M-Welsch/base-hardware/circuit_boards/base_hmi/assembly/BaSe_HMI_V1_1.png

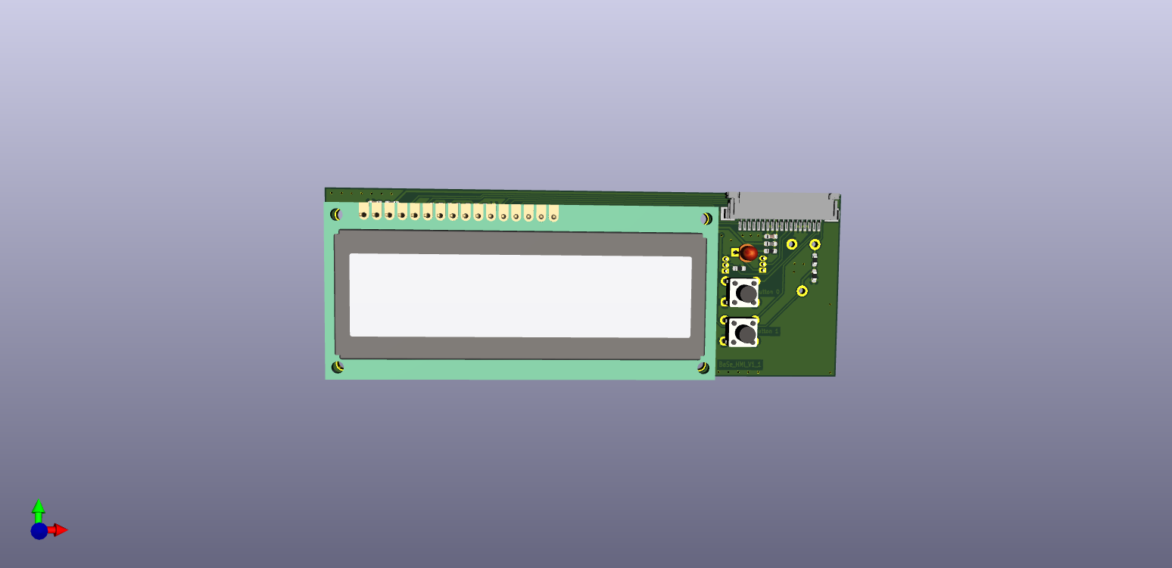
circuit_boards/base_hmi/assembly/BaSe_HMI_V1_1.png
