M-Welsch/base-hardware/bill_of_materials/BaSe_rev3b_Stueckliste_V1_0.pdf

Sheet1

## Stückliste BaSe HW rev3b

Position Bezeichnung | Menge Einzelpreis Gesamtpreis
100 | BananaPi Mk1 | 1 | 38,01 € | 38,01 €
200 | BaSe_PWR_V3_2 Leiterplatte | 0,2 | 11,30 € | 2,26 €
201 | BaSe_PWR_V3_2 Bauteile | 1 | 45,79 € | 45,79 €
202 | Schrittmotor Treibermodul | 0,2 | 7,99 € | 1,60 €
203 | Micro-USB Stecker | 0,05 | 9,39 € | 0,47 €
210 | BaSe_HMI_V1_1 Leiterplatte | 0,2 | 6,30 € | 1,26 €
211 | BaSe_HMI_V1_1 Bauteile | 1 | 4,77 € | 4,77 €
212 | Display Modul | 0,2 | 10,49 € | 2,10 €
220 | BaSe_SATA_Adapter_Carriage_V1_1 Leiterplatte | 0,2 | 3,00 € | 0,60 €
221 | BaSe_SATA_Adapter_Carriage_V1_1 Bauteile | 1 | 5,89 € | 5,89 €
230 | BaSe_SATA_Adapter_HDD_V1_1 Leiterplatte | 0,2 | 5,00 € | 1,00 €
231 | BaSe_SATA_Adapter_HDD_V1_1 Bauteile | 1 | 10,39 € | 10,39 €
300 | BaSe_Auflager_Platinen_rev3.stl
301 | BaSe_Bodenplatte_rev3.stl
302 | BaSe_BP_HDD_rev1.stl
303 | BaSe_HMI_Display_Abstandsrahmen_rev1.stl
304 | BaSe_rev1_Spannlager_Gegenstueck_2020_07_19.stl
305 | BaSe_Schlitten_rev3_2020_07_19.stl
400 | Schrittmotor: Nema 17 | 1 | 12,61 € | 12,61 €
401 | Gewindekupplungen | 0,2 | 7,99 € | 1,60 €
402 | Gewindestange (10cm) | 0,2 | 13,69 € | 2,74 €
403 | Linearführung + Gleitlager + Spannbacken | 1 | 7,89 € | 7,89 €
404 | Endschalter (KW4-3Z-3 Schnappsch gs) | 0,4 | 4,09 € | 1,64 €
| | | Summe | 140,61 €

Stand: 29.08.2020
