M-Welsch/base-hardware/3d_printing_parts/BaSe_BP_HDD_rev1.stl

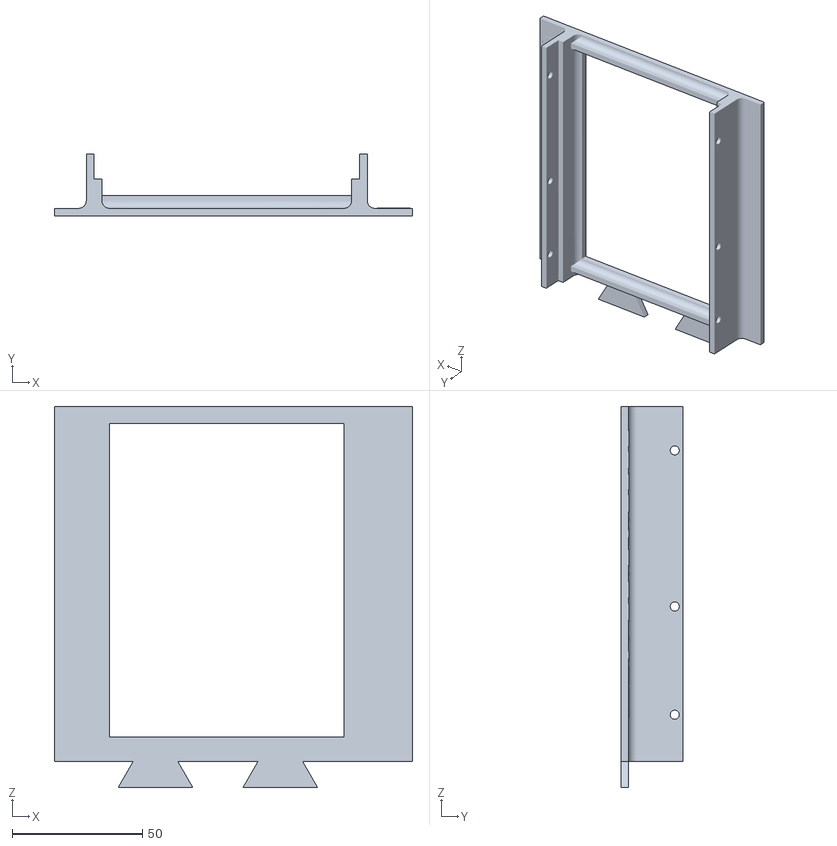
[picture p2: CAD file, 2023-03-08]
3d_printing_parts/BaSe_BP_HDD_rev1.stl
137.7 x 24.0 x 146.5
