M-Welsch/base-hardware/3d_printing_parts/BaSe_HMI_Display_Abstandsrahmen_rev1.stl

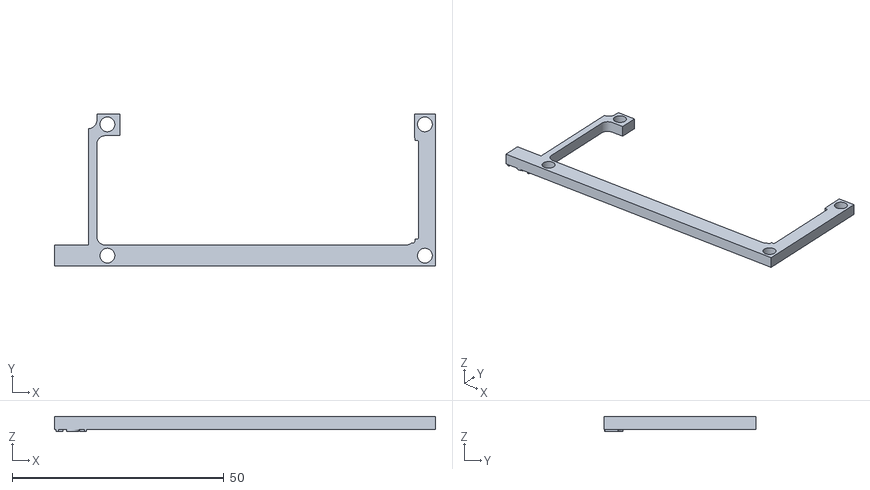
[picture p3: CAD file, 2023-03-08]
3d_printing_parts/BaSe_HMI_Display_Abstandsrahmen_rev1.stl
90.0 x 36.0 x 3.50
