M-Welsch/base-hardware/3d_printing_parts/BaSe_Auflager_Platinen_rev4.stl

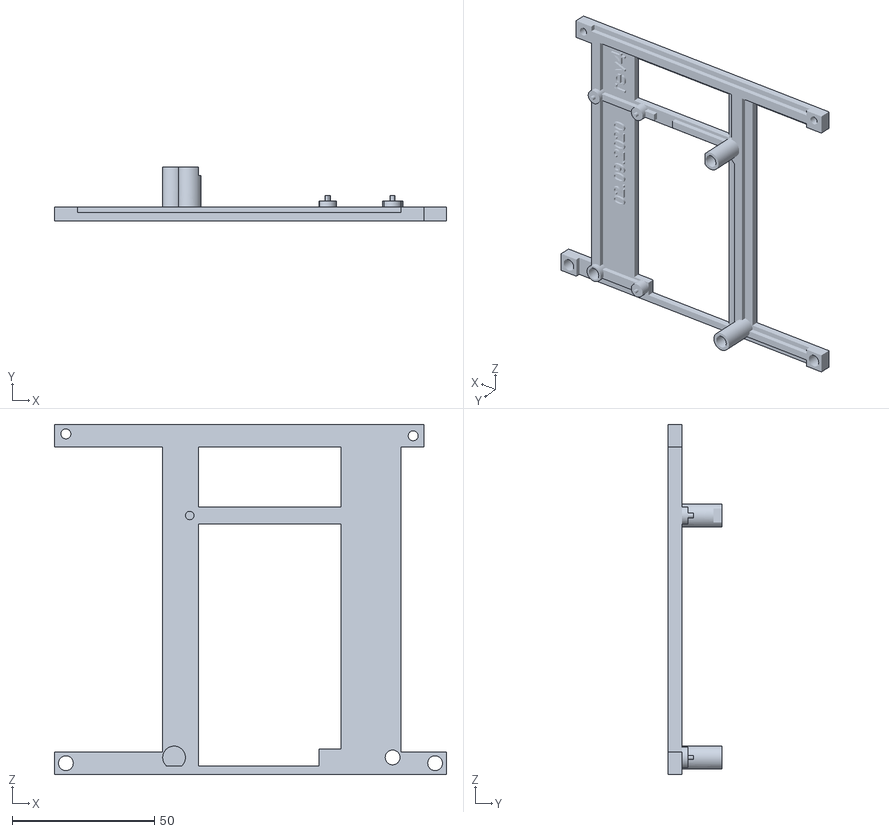
[picture p4: CAD file, 2023-03-08]
3d_printing_parts/BaSe_Auflager_Platinen_rev4.stl
137.7 x 19.0 x 123.0
