M-Welsch/base-hardware/3d_printing_parts/BaSe_Bodenplatte_rev3.stl

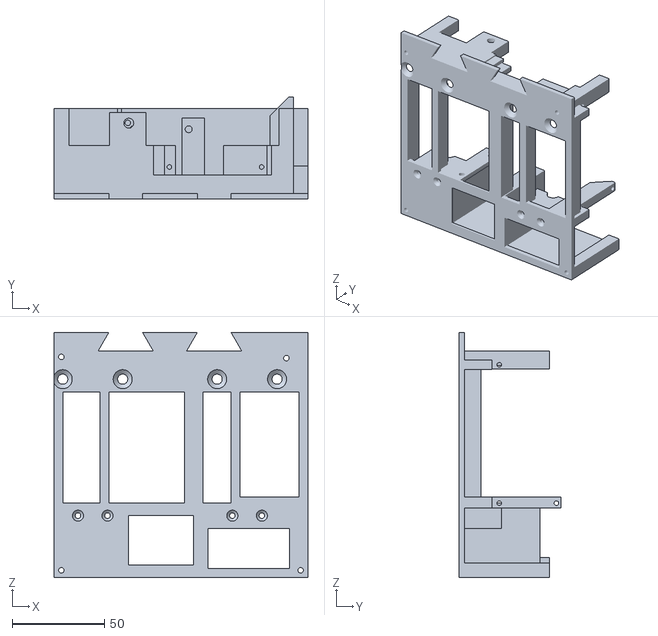
[picture p5: CAD file, 2023-03-08]
3d_printing_parts/BaSe_Bodenplatte_rev3.stl
137.7 x 55.3 x 133.0
