M-Welsch/base-hardware/3d_printing_parts/BaSe_rev1_Spannlager_Gegenstueck_2020_07_19.stl

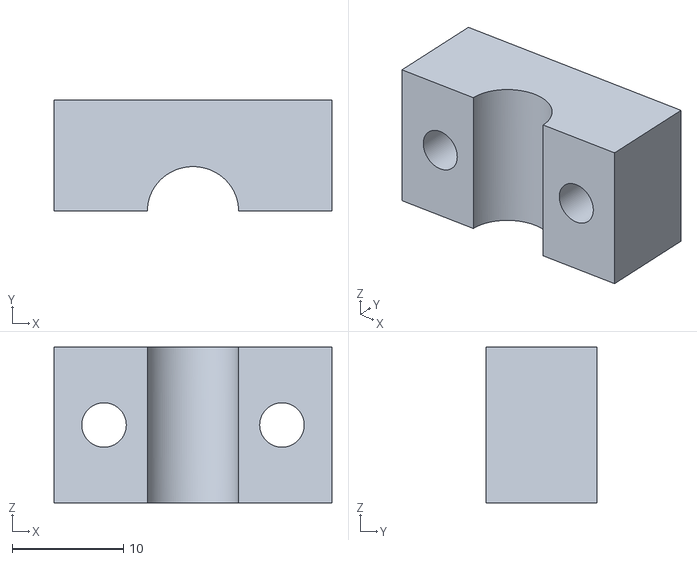
[picture p6: CAD file, 2023-03-08]
3d_printing_parts/BaSe_rev1_Spannlager_Gegenstueck_2020_07_19.stl
25.0 x 10.0 x 14.0
