M-Welsch/base-hardware/3d_printing_parts/BaSe_Schlitten_rev3_2020_07_19.stl

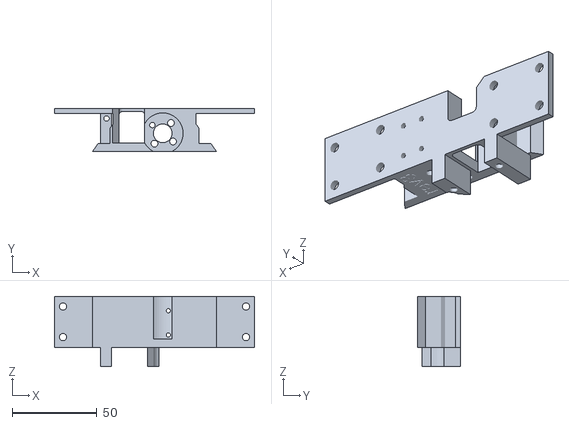
[picture p7: CAD file, 2023-03-08]
3d_printing_parts/BaSe_Schlitten_rev3_2020_07_19.stl
117.7 x 25.3 x 41.4
