M-Welsch/base-hardware/circuit_boards/base_pwr/BaSe_PWR_V4_0.kicad_pcb

## KiCad design circuit_boards/base_pwr/BaSe_PWR_V4_0.kicad_pcb (2024-01-03)

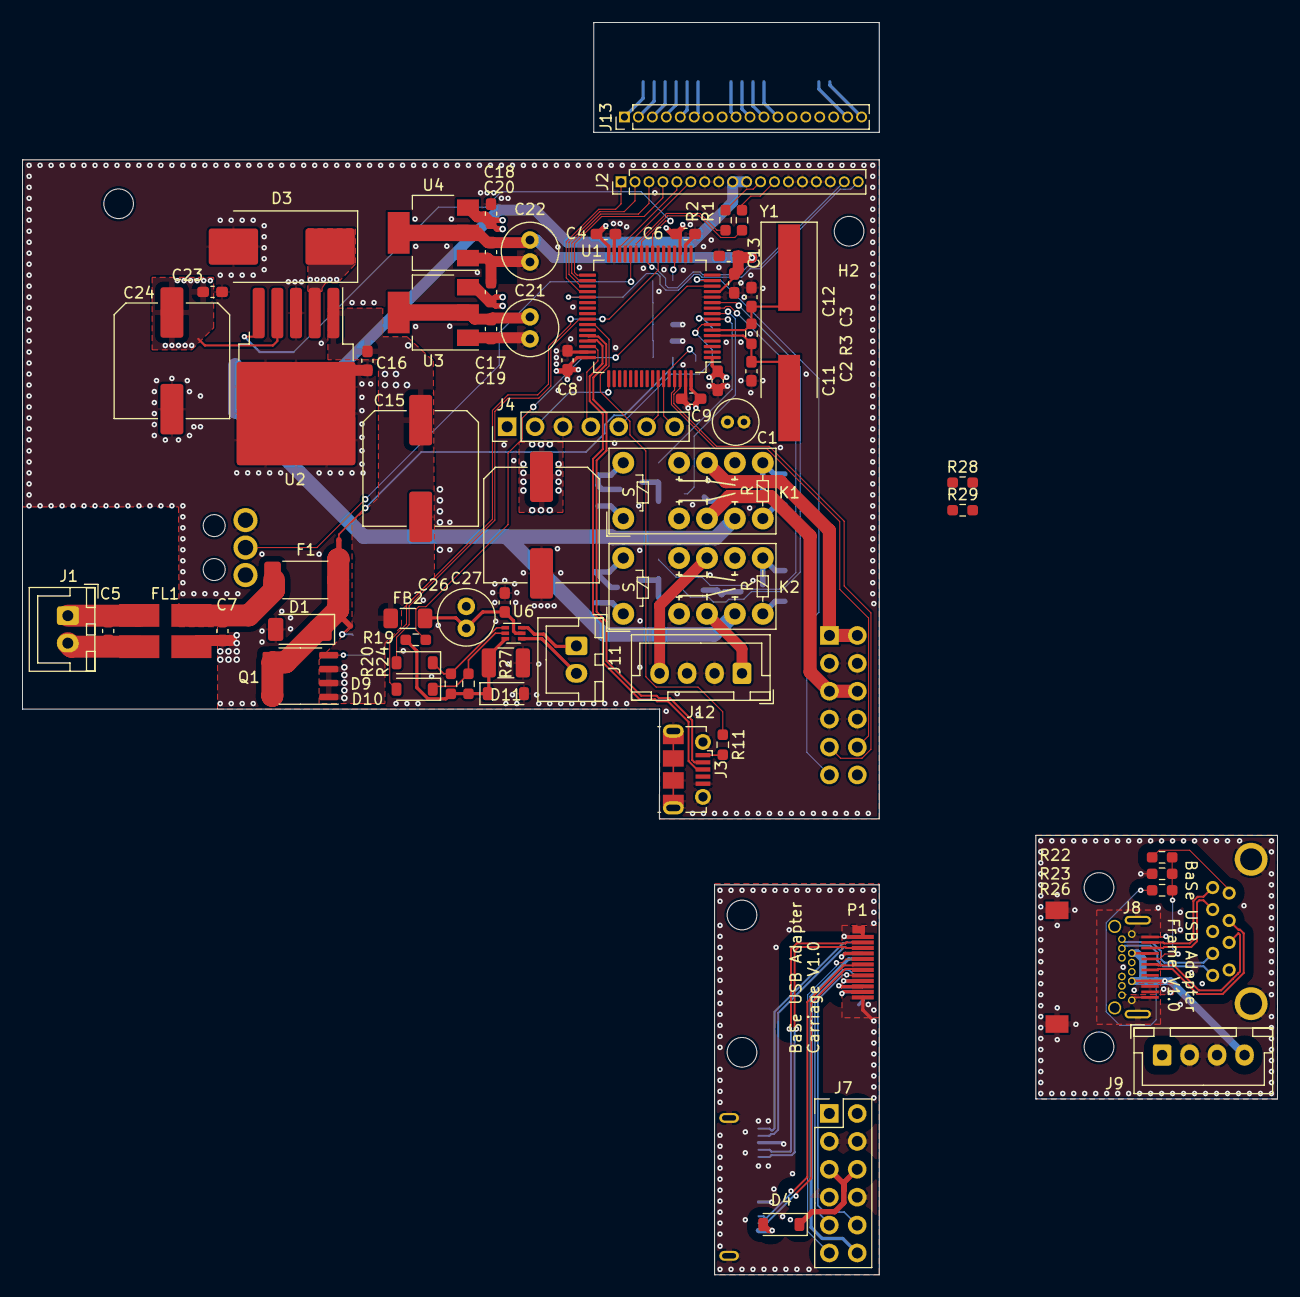
[picture p8: board BaSe_PWR_V4_0.kicad_pcb from above]

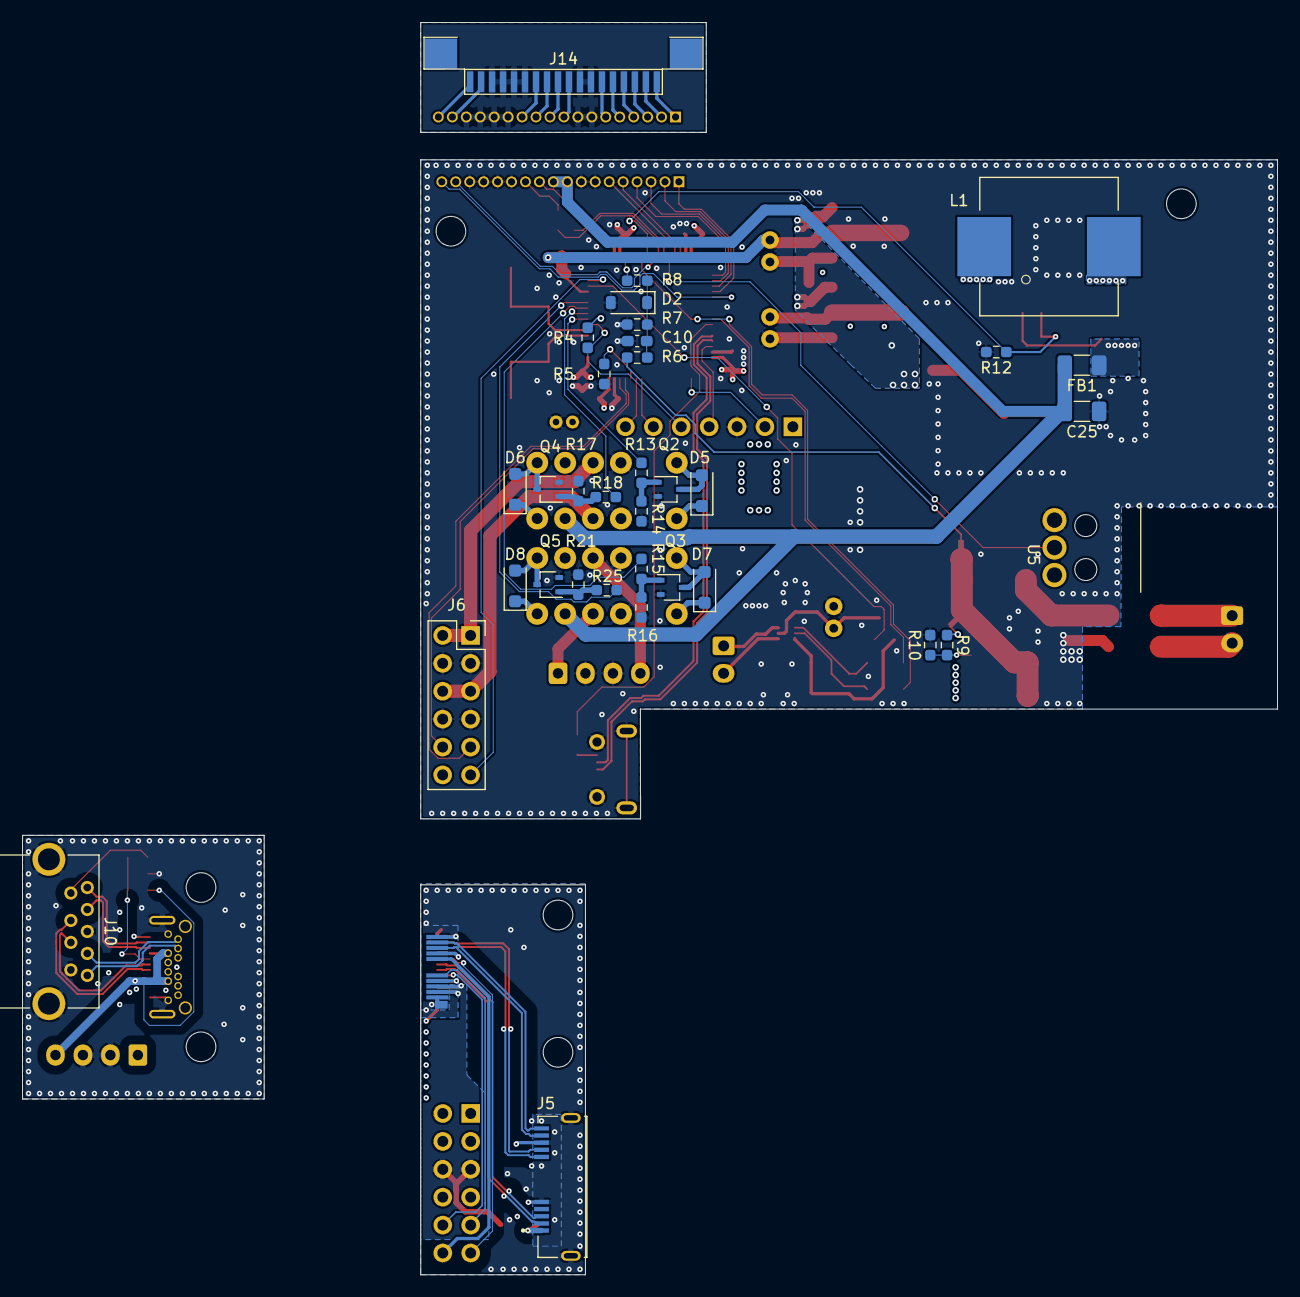
[picture p9: board BaSe_PWR_V4_0.kicad_pcb from below]

Board: 4 copper layers, 78.0 x 60.0 mm, 109 parts (34 on the bottom side), 106 nets.

Parts:
C1: 4.7µF; C_Radial_D4.0mm_H7.0mm_P1.50mm
C2, C3: 20pF; C_0603_1608Metric_Pad1.08x0.95mm_HandSolder
C4, C6, C8, C9, C10, C11, C16, C17, C18, C19, C20, C23, C27: 100nF; C_0603_1608Metric_Pad1.08x0.95mm_HandSolder
C5, C7: C_0603_1608Metric_Pad1.08x0.95mm_HandSolder
C12: 10nF; C_0603_1608Metric_Pad1.08x0.95mm_HandSolder
C13: 1µF; C_0603_1608Metric_Pad1.08x0.95mm_HandSolder
C14, C15, C24: 220µF; C_Elec_10x10.2
C21, C22, C26: 22µF; C_Radial_D5.0mm_H11.0mm_P2.00mm
C25: 10µF; C_1206_3216Metric_Pad1.33x1.80mm_HandSolder
D1: 824501121; D_SOD-128
D2, D9, D10: SD103CW-E3-08; D_SOD-123
D3: SK34-TP; D_SMC_Handsoldering
D4: SK64L-TPMSCT-ND; D_SOD-123
D5, D6, D7, D8: 1N4148WRHGCT-ND; D_SOD-123F
D11: 2.5V; D_SOD-123
F1: Fuse_2512_6332Metric_Pad1.52x3.35mm_HandSolder
FB1, FB2: FerriteBead; C_1206_3216Metric_Pad1.33x1.80mm_HandSolder
FL1: CMC_Laird_CM2021Y330R-10
H1, H2, H3, H4, H5, H6: MountingHole; MountingHole_2.7mm_M2.5_DIN965
J1: 12VDC In; JST_XH_B2B-XH-A_1x02_P2.50mm_Vertical
J2: HRS-1B-16-GA; PinHeader_1x18_P1.27mm_Vertical
J3: USB_B_Micro; USB_Micro-B_Molex-105017-0001
J4: Conn_01x07_Pin; PinHeader_1x07_P2.54mm_Vertical
J5: USB3_B_Micro; conn_usb3bmicro_GSB343K331HR
J6: Conn_02x06_Odd_Even; PinSocket_2x06_P2.54mm_Vertical
J7: Conn_02x06_Odd_Even; PinHeader_2x06_P2.54mm_Vertical
J8: USB_C_Receptacle; conn_usbc_socket_RAHPCUC31AU1TR
J9, J12: Conn_01x04_Socket; JST_XH_B4B-XH-A_1x04_P2.50mm_Vertical
J10: USB3_A; STEWARD_USB3_A_SS-52000-001
J11: MOTOR; JST_XH_B2B-XH-A_1x02_P2.50mm_Vertical
J13: HPH1-A-16-UA; PinHeader_1x18_P1.27mm_Vertical
J14: molex_fcc_05220
K1, K2: Kemet_EC2-12TNU
L1: 47µH; L_Wuerth_WE-PD-Typ-LS_Handsoldering
NT1, NT2: NetTie_2; NetTie-2_SMD_Pad0.5mm
P1: USB_C_Plug; Molex_USBC_Plug_1054440011
Q1: AOSP21321; SO-8_3.9x4.9mm_P1.27mm
Q2, Q3, Q4, Q5: BSS214NW; SOT-323_SC-70
R1, R2, R8, R10: 100; R_0603_1608Metric_Pad0.98x0.95mm_HandSolder
R3: R; R_0603_1608Metric_Pad0.98x0.95mm_HandSolder
R4, R5, R11, R20, R24, R28: 10k; R_0603_1608Metric_Pad0.98x0.95mm_HandSolder
R6, R9: 100k; R_0603_1608Metric_Pad0.98x0.95mm_HandSolder
R7: 24,9k; R_0603_1608Metric_Pad0.98x0.95mm_HandSolder
R12, R14, R16, R17, R21: 47k; R_0603_1608Metric_Pad0.98x0.95mm_HandSolder
R13, R15, R18, R19, R25: 1k; R_0603_1608Metric_Pad0.98x0.95mm_HandSolder
R22: 13,3k; R_0603_1608Metric_Pad0.98x0.95mm_HandSolder
R23: 3,16k; R_0603_1608Metric_Pad0.98x0.95mm_HandSolder
R26: 15,8k; R_0603_1608Metric_Pad0.98x0.95mm_HandSolder
R27: R; R_1210_3225Metric_Pad1.30x2.65mm_HandSolder
R29: 8,87k; R_0603_1608Metric_Pad0.98x0.95mm_HandSolder
U1: STM32F070RBTx; LQFP-64_10x10mm_P0.5mm
U2: LM2596S-5; TO-263-5_TabPin3
U3, U4: AMS1117-3.3; SOT-223-3_TabPin2
U5: TS0101F020V4
U6: DRV8220; SOT-563
Y1: 8MHz; Crystal_SMD_HC49-SD_HandSoldering

Connections:
+3.3VA: C12.1, C13.1, C20.1, C22.1, U1.13 (VDDA), U4.2 (VO)
+3V3_STBY: C1.1, C4.1, C6.1, C8.1, C9.1, C11.1, C19.1, C21.1, J4.1, J6.12, R4.2, R28.1, R29.2, U1.1 (VDD), U1.19 (VDD), U1.32 (VDD), U1.48 (VDD), U1.64 (VDD), U3.2 (VO)
+5V: C25.2, FB1.2, J2.9, J2.10, K1.5, K2.5
+5VA: J8.A10 (RX2-), J8.A11 (RX2+), J8.B2 (TX2+), J8.B3 (TX2-), J9.1, J10.1 (VBUS), R22.1
+12V: C14.1, C15.1, C16.2, C17.1, C18.1, D5.1 (K), D6.1 (K), D7.1 (K), D8.1 (K), FB2.1, K1.1, K1.6, K1.8, K2.1, K2.6, K2.8, Q1.1 (S), Q1.2 (S), Q1.3 (S), U2.1 (VIN), U3.3 (VI), U4.3 (VI)
+12VA: J8.A4 (VBUS), J8.A9 (VBUS), J8.B4 (VBUS), J8.B9 (VBUS), J9.4, R26.1
/12v_motor: C26.1, C27.1, FB2.2, U6.5 (VM)
/12vin_meas: R8.2, U1.20 (PA4)
/+5V_HDD: J6.5, J6.6, K1.4
/+5V_HDD_: D4.1 (K), J7.5, J7.6, P1.A10 (RX2-), P1.A11 (RX2+), P1.B2 (TX2+), P1.B3 (TX2-)
/+5V_sbu: J12.1, K2.4
/+5v_out: C23.2, C24.1, FB1.1, L1.2, U2.4 (FB)
/+12V_HDD: J6.1, J6.2, K1.9
/+12V_HDD_: J7.1, J7.2, P1.A4 (VBUS), P1.A9 (VBUS), P1.B4 (VBUS), P1.B9 (VBUS)
/+12V_sbu: J12.4, K2.9
/DC_IN+: C5.2, FL1.1, J1.1
/DC_IN-: C5.1, FL1.2, J1.2
/DC_prefuse: C7.1, F1.2, FL1.4
/DC_preprot: D1.1 (A1), F1.1, NT1.2, NT2.2, Q1.5 (D), Q1.6 (D), Q1.7 (D), Q1.8 (D)
/Dis_DB4: J2.4, U1.33 (PB12)
/Dis_DB5: J2.3, U1.34 (PB13)
/Dis_DB6: J2.2, U1.35 (PB14)
/Dis_DB7: J2.1, U1.36 (PB15)
/Dis_E: J2.5, U1.30 (PB11)
/Dis_PWM: J2.12, R1.2
/Dis_RS: J2.6, U1.29 (PB10)
/GND_HMI: J13.7, J13.8, J13.13, J13.14, J13.15, J13.16, J14.7, J14.8, J14.13, J14.14, J14.15, J14.16
/LED_HMI: J2.11, R2.2
/SW: D3.1 (K), L1.1, U2.2 (OUT)
/SW_HDD_Off: R18.1, U1.9 (PC1)
/SW_HDD_On: R13.1, U1.8 (PC0)
/Taster_0: J2.17, U1.25 (PC5)
/Taster_1: J2.18, U1.37 (PC6)
/USB_D+: J3.3 (D+), U1.45 (PA12)
/USB_D-: J3.2 (D-), U1.44 (PA11)
/aux_3v3: J7.12, P1.B8 (SBU2)
/aux_i2c_scl: J7.10, P1.A8 (SBU1)
/aux_i2c_sda: J7.9, P1.B5 (VCONN)
/boot0: R5.1, U1.60 (BOOT0)
/hmi_pwm0: R1.1, U1.26 (PB0)
/hmi_pwm1: R2.1, U1.27 (PB1)
/i2c1_scl: J6.10, U1.61 (PB8)
/i2c1_sda: J6.9, U1.62 (PB9)
/imotor: D11.1 (K), R19.2, R20.2, R24.2, R27.1, U6.3 (GND)
/imotor_prot: R19.1, U1.14 (PA0)
/in1: D9.1 (K), R20.1, U6.1 (IN1)
/in1_mcu: D9.2 (A), U1.41 (PA8)
/in2: D10.1 (K), R24.1, U6.2 (IN2)
/in2_mcu: D10.2 (A), U1.23 (PA7)
/l1_rx+: J8.B11 (RX1+), J10.6 (SSRX+)
/l1_rx-: J8.B10 (RX1-), J10.5 (SSRX-)
/l1_tx+: J8.A2 (TX1+), J10.9 (SSTX+)
/l1_tx-: J8.A3 (TX1-), J10.8 (SSTX-)
/lane1_d+: J8.A6 (D+), J10.3 (D+)
/lane1_d-: J8.A7 (D-), J10.2 (D-)
/motor1: J11.1, U6.6 (OUT1)
/motor2: J11.2, U6.4 (OUT2)
/stator_d+: J5.3 (D+), P1.A6 (D+)
/stator_d-: J5.2 (D-), P1.A7 (D-)
/stator_rx+: J5.10 (SSRX+), P1.B11 (RX1+)
/stator_rx-: J5.9 (SSRX-), P1.B10 (RX1-)
/stator_supply_sense: J6.11, R29.1, U1.15 (PA1)
/stator_supply_sense_: J7.11, P1.A5 (CC), R28.2
/stator_tx+: J5.7 (SSTX+), P1.A2 (TX1+)
/stator_tx-: J5.6 (SSTX-), P1.A3 (TX1-)
/supply_sense: J8.A5 (CC1), R22.2, R23.1, R26.2
/sw_sbu_off: R25.1, U1.11 (PC3)
/sw_sbu_on: R15.1, U1.10 (PC2)
/swclk: J4.2, U1.49 (PA14)
/swdio: J4.4, U1.46 (PA13)
/usart1_rx: J4.7, U1.59 (PB7)
/usart1_tx: J4.6, U1.58 (PB6)
/vbus_sense: R11.1, U1.42 (PA9)
/~LM2596S_ON: R12.1, U1.24 (PC4), U2.5 (~ON/OFF)
/~endswitch_undocked: U1.28 (PB2), U5.NO
/~rst: J4.5, R4.1, U1.7 (NRST)
GND: C1.2, C2.1, C3.1, C4.2, C6.2, C7.2, C8.2, C9.2, C10.2, C11.2, C12.2, C13.2, C14.2, C15.2, C16.1, C17.2, C18.2, C19.2, C20.2, C21.2, C22.2, C23.1, C24.2, C25.1, C26.2, C27.2, D1.2 (A2), D2.2 (A), D3.2 (A), D11.2 (A), FL1.3, J2.7, J2.8, J2.13, J2.14, J2.15, J2.16, J3.5 (GND), J3.6 (Shield), J4.3, J6.3, J6.4, J6.7, J6.8, J12.2, J12.3, K1.3, K1.10, K2.3, K2.10, Q2.2 (S), Q3.2 (S), Q4.2 (S), Q5.2 (S), R5.2, R7.1, R10.2, R12.2, R14.1, R16.1, R17.1, R21.1, R27.2, U1.12 (VSSA), U1.18 (VSS), U1.31 (VSS), U1.47 (VSS), U1.63 (VSS), U2.3 (GND), U3.1 (GND), U4.1 (GND), U5.C
GND1: J5.5 (GND), J5.8 (DRAIN), J5.11 (SHIELD), J7.3, J7.4, J7.7, J7.8, P1.A1 (GND), P1.A12 (GND), P1.B1 (GND), P1.B12 (GND), P1.S1 (SHIELD)
GND2: J8.A1 (GND), J8.A12 (GND), J8.B1 (GND), J8.B12 (GND), J8.S1 (SHIELD), J9.2, J9.3, J10.4 (GND), J10.7 (DRAIN), J10.10 (SHIELD), R23.2
unnamed: C10.1, D2.1 (K), R6.1, R7.2, R8.1
unnamed: D4.2 (A), J5.1 (VBUS)
unnamed: D5.2 (A), K1.12, Q2.3 (D)
unnamed: D6.2 (A), K1.7, Q4.3 (D)
unnamed: D7.2 (A), K2.12, Q3.3 (D)
unnamed: D8.2 (A), K2.7, Q5.3 (D)
unnamed: J3.1 (VBUS), R11.2
unnamed: J13.1, J14.1
unnamed: J13.2, J14.2
unnamed: J13.3, J14.3
unnamed: J13.4, J14.4
unnamed: J13.5, J14.5
unnamed: J13.6, J14.6
unnamed: J13.9, J13.10, J14.9, J14.10
unnamed: J13.11, J14.11
unnamed: J13.12, J14.12
unnamed: J13.17, J14.17
unnamed: J13.18, J14.18
unnamed: NT1.1, R6.2
unnamed: NT2.1, R9.1
unnamed: Q1.4 (G), R9.2, R10.1
unnamed: Q2.1 (G), R13.2, R14.2
unnamed: Q3.1 (G), R15.2, R16.2
unnamed: Q4.1 (G), R17.2, R18.2
unnamed: Q5.1 (G), R21.2, R25.2
unnamed: C2.2, R3.1, U1.5 (PF0), Y1.2
unnamed: C3.2, R3.2, U1.6 (PF1), Y1.1
