M-Welsch/base-hardware/circuit_boards/base_usb_adapter_carriage/BaSe_USB_Adapter_Carriage_V1_0.kicad_pcb

## KiCad design circuit_boards/base_usb_adapter_carriage/BaSe_USB_Adapter_Carriage_V1_0.kicad_pcb (2023-03-12)

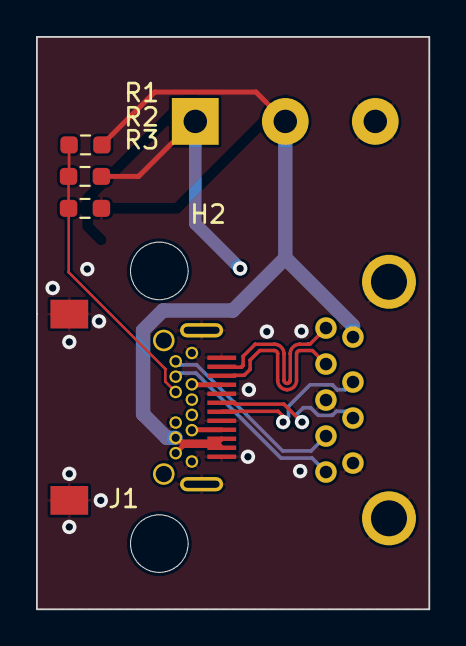
[picture p10: board BaSe_USB_Adapter_Carriage_V1_0.kicad_pcb from above]

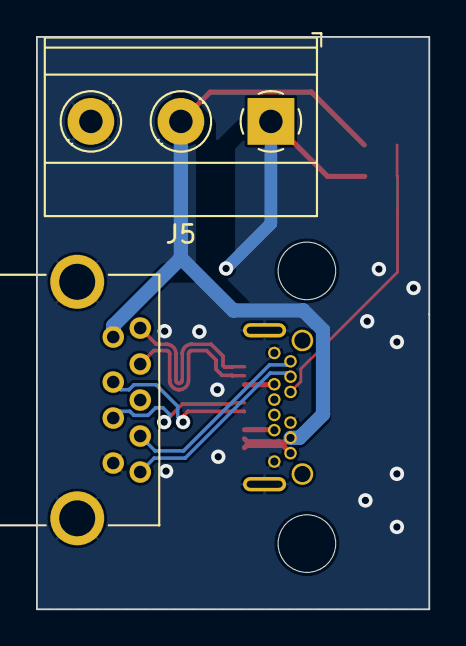
[picture p11: board BaSe_USB_Adapter_Carriage_V1_0.kicad_pcb from below]

Board: 4 copper layers, 21.8 x 31.8 mm, 8 parts (2 on the bottom side), 10 nets.

Parts:
H1, H2: MountingHole; MountingHole_3.2mm_M3_DIN965
J1: USB_C_Receptacle; conn_usbc_socket_RAHPCUC31AU1TR
J3: USB3_A; STEWARD_USB3_A_SS-52000-001
J5: Screw_Terminal_01x03; TerminalBlock_Phoenix_MKDS-1,5-3_1x03_P5.00mm_Horizontal
R1: 31k6; R_0603_1608Metric_Pad0.98x0.95mm_HandSolder
R2: 38k3; R_0603_1608Metric_Pad0.98x0.95mm_HandSolder
R3: 10k; R_0603_1608Metric_Pad0.98x0.95mm_HandSolder

Connections:
+5V: J1.A10 (RX2-), J1.A11 (RX2+), J1.B2 (TX2+), J1.B3 (TX2-), J3.1 (VBUS), J5.2, R1.1
+12V: J1.A4 (VBUS), J1.A9 (VBUS), J1.B4 (VBUS), J1.B9 (VBUS), J5.1, R2.1
/l1_rx+: J1.B11 (RX1+), J3.6 (SSRX+)
/l1_rx-: J1.B10 (RX1-), J3.5 (SSRX-)
/l1_tx+: J1.A2 (TX1+), J3.9 (SSTX+)
/l1_tx-: J1.A3 (TX1-), J3.8 (SSTX-)
/lane1_d+: J1.A6 (D+), J3.3 (D+)
/lane1_d-: J1.A7 (D-), J3.2 (D-)
/supply_sense: J1.B8 (SBU2), R1.2, R2.2, R3.1
GND2: J1.A1 (GND), J1.A5 (CC1), J1.A8 (SBU1), J1.A12 (GND), J1.B1 (GND), J1.B5 (CC2), J1.B12 (GND), J1.S1 (SHIELD), J3.4 (GND), J3.7 (DRAIN), J3.10 (SHIELD), J5.3, R3.2
