M-Welsch/base-hardware/circuit_boards/base_dc_motor_test/BaSe_DC_Motor_Test_V1_0.kicad_pcb

## KiCad design circuit_boards/base_dc_motor_test/BaSe_DC_Motor_Test_V1_0.kicad_pcb (2023-03-08)

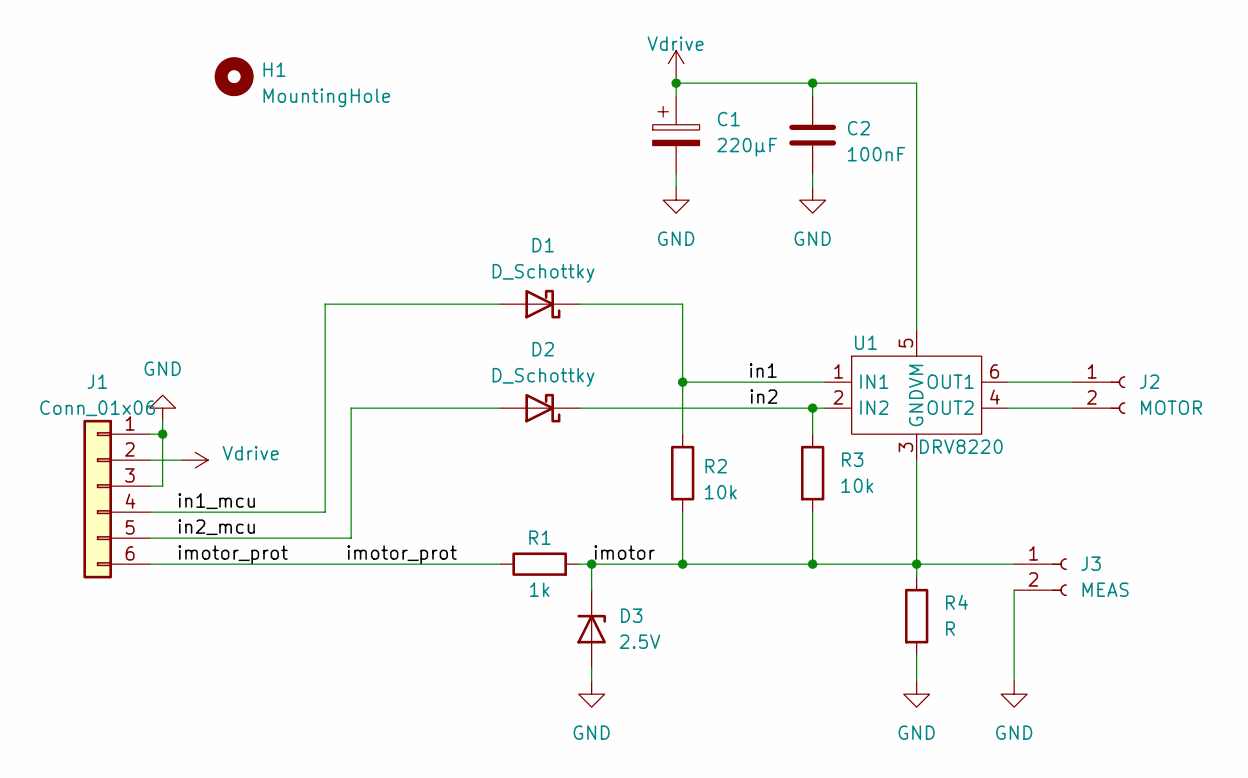
[picture p12: schematic BaSe_DC_Motor_Test_V1_0.kicad_sch]

Parts:
C1: 220µF; C_Elec_6.3x7.7
C2: 100nF; C_0603_1608Metric_Pad1.08x0.95mm_HandSolder
D1, D2: D_Schottky; D_SOD-123; MPN SD103CW-E3-08
D3: 2.5V; D_SOD-123
H1: MountingHole; MountingHole_3.2mm_M3
J1: Conn_01x06; PinHeader_1x06_P2.54mm_Vertical
J2: MOTOR; PinHeader_1x02_P2.54mm_Vertical
J3: MEAS; PinHeader_1x02_P2.54mm_Vertical
R1: 1k; R_0603_1608Metric_Pad0.98x0.95mm_HandSolder
R2, R3: 10k; R_0603_1608Metric_Pad0.98x0.95mm_HandSolder
R4: R; R_1210_3225Metric_Pad1.30x2.65mm_HandSolder
U1: DRV8220; SOT-563

Connections:
/imotor: D3.1 (K), J3.1, R1.2, R2.2, R3.2, R4.1, U1.3 (GND)
/imotor_prot: J1.6, R1.1
/in1: D1.1 (K), R2.1, U1.1 (IN1)
/in1_mcu: D1.2 (A), J1.4
/in2: D2.1 (K), R3.1, U1.2 (IN2)
/in2_mcu: D2.2 (A), J1.5
GND: C1.2, C2.2, D3.2 (A), J1.1, J1.3, J3.2, R4.2
unnamed: J2.1, U1.6 (OUT1)
unnamed: J2.2, U1.4 (OUT2)
Vdrive: C1.1, C2.1, J1.2, U1.5 (VM)

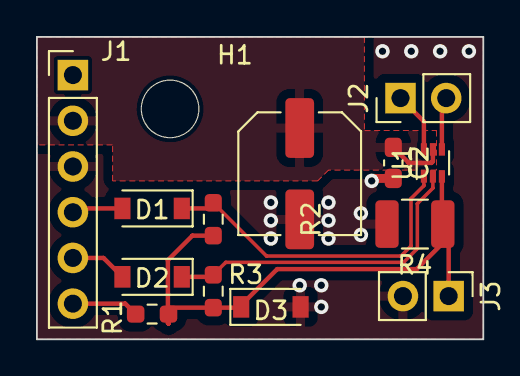
[picture p13: board BaSe_DC_Motor_Test_V1_0.kicad_pcb from above]

Board: 2 copper layers, 24.8 x 16.8 mm, 14 parts (0 on the bottom side), 10 nets.
