M-Welsch/base-hardware/circuit_boards/base_hmi/BaSe_HMI_V1_1.kicad_pcb

## KiCad design circuit_boards/base_hmi/BaSe_HMI_V1_1.kicad_pcb (2023-03-08)

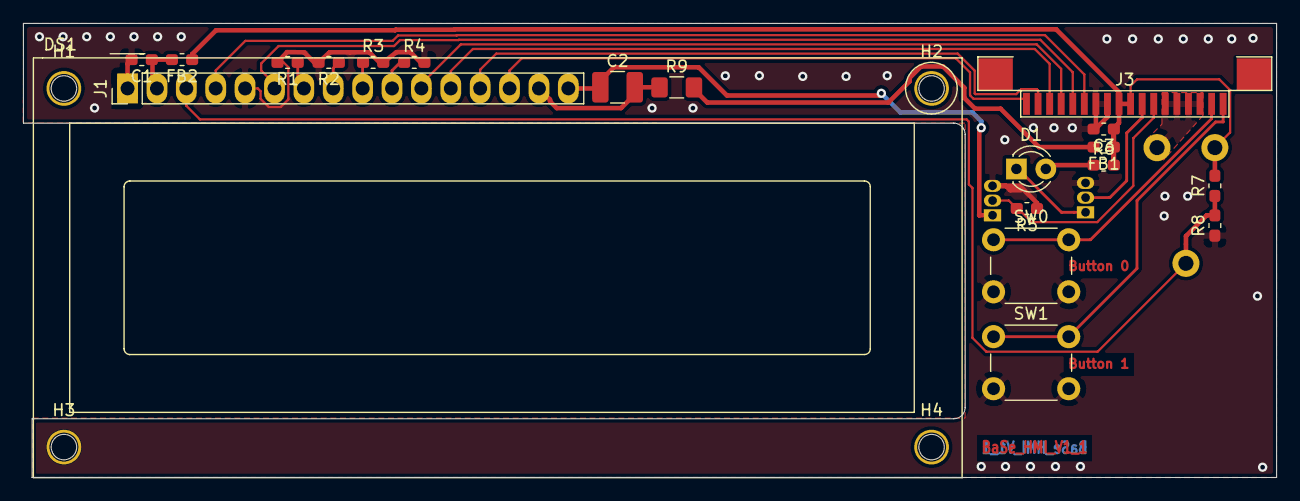
[picture p14: board BaSe_HMI_V1_1.kicad_pcb from above]

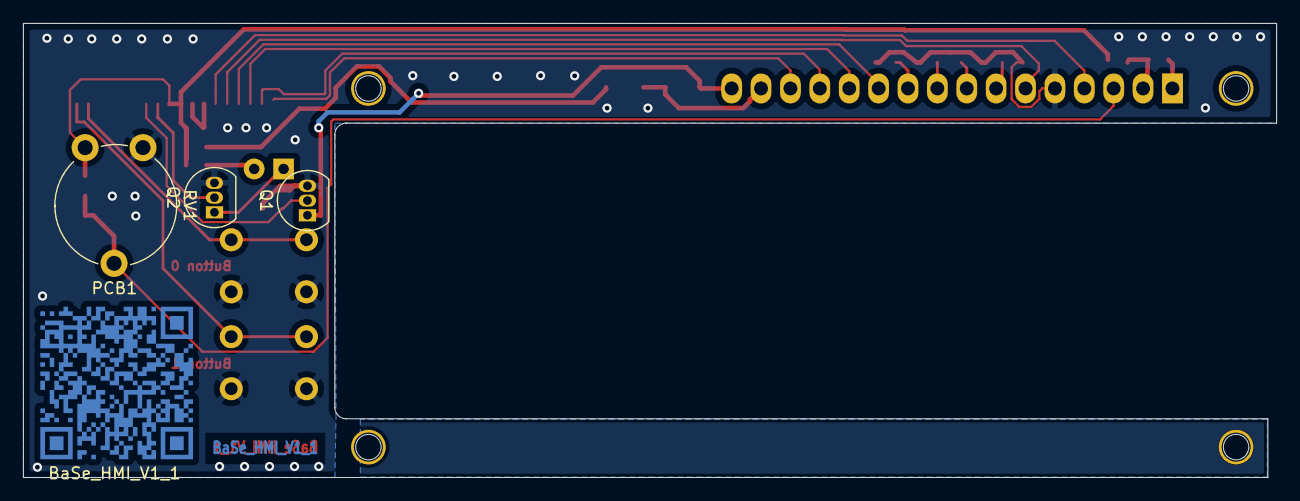
[picture p15: board BaSe_HMI_V1_1.kicad_pcb from below]

Board: 2 copper layers, 108.3 x 39.2 mm, 28 parts (4 on the bottom side), 23 nets.

Parts:
C1, C3: 100nF; C_0603_1608Metric_Pad1.05x0.95mm_HandSolder
C2: 100µF; C_1210_3225Metric_Pad1.42x2.65mm_HandSolder
D1: LED; LED_D3.0mm_9.5mm_Standoff
DS1: WC1602A; WC1602A_3.5mm_over_PCB
FB1, FB2: 742792602; L_0603_1608Metric_Pad1.05x0.95mm_HandSolder
H1, H2, H3, H4: MountingHole; MountingHole_2.2mm_M2
J1: Conn_01x16; PinHeader_1x16_P2.54mm_Vertical
J3: 0522071860; Conn_FFC_Molex_52207-1860
PCB1: BaSe_HMI_V1_1
Q1, Q2: BS170; TO-92_Inline
R1, R2, R3, R4: NO; R_0603_1608Metric_Pad1.05x0.95mm_HandSolder
R5: 10k; R_0603_1608Metric_Pad1.05x0.95mm_HandSolder
R6: 56R; R_0603_1608Metric_Pad1.05x0.95mm_HandSolder
R7: 43k; R_0603_1608Metric_Pad1.05x0.95mm_HandSolder
R8: 2k2; R_0603_1608Metric_Pad1.05x0.95mm_HandSolder
R9: 4,3R; R_1206_3216Metric_Pad1.42x1.75mm_HandSolder
RV1: R_POT; Potentiometer_Piher_PT-10-V10_Vertical
SW0, SW1: SW_Push; SW_PUSH_6mm_H7.3mm

Connections:
+5V: C3.1, FB1.1, FB2.1, J3.9, J3.10, R6.2, R7.2, RV1.1
/Dis_DB4: DS1.11, J1.11, J3.15
/Dis_DB5: DS1.12, J1.12, J3.16
/Dis_DB6: DS1.13, J1.13, J3.17
/Dis_DB7: DS1.14, J1.14, J3.18
/Dis_E: DS1.6, J3.14
/Dis_PWM: J3.7, Q1.2, R5.2
/Dis_RS: DS1.4, J3.13
/Dis_Vdd: C1.1, DS1.2, FB2.2
/LED+: C2.2, DS1.15, J1.15, R9.1
/LED-: C2.1, DS1.16, J1.16, Q1.1
/LED_HMI: J3.8, Q2.2
/Taster_0: J3.2, SW0.1
/Taster_1: J3.1, SW1.1
GND: C1.2, C3.2, DS1.1, DS1.5, J1.1, J1.5, J3.3, J3.4, J3.5, J3.6, J3.11, J3.12, Q1.3, Q2.3, R1.2, R2.2, R3.2, R4.2, R5.1, R8.1, RV1.3, SW0.2, SW1.2
unnamed: D1.1, Q2.1
unnamed: D1.2, R6.1
unnamed: DS1.3, R7.1, R8.2, RV1.2
unnamed: DS1.7, R1.1
unnamed: DS1.8, R2.1
unnamed: DS1.9, R3.1
unnamed: DS1.10, R4.1
unnamed: FB1.2, R9.2
