M-Welsch/base-hardware/circuit_boards/base_sata_adapter_hdd/BaSe_SATA_Adapter_HDD_V1_0.kicad_pcb

## KiCad design circuit_boards/base_sata_adapter_hdd/BaSe_SATA_Adapter_HDD_V1_0.kicad_pcb (2023-03-08)

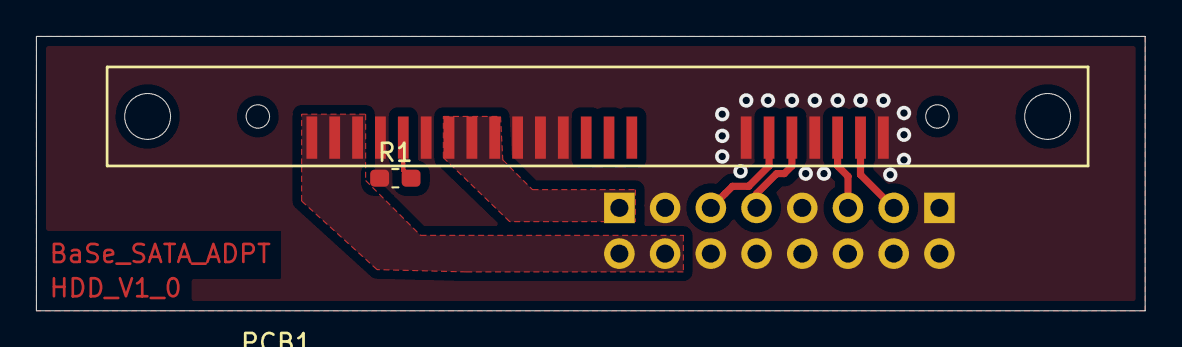
[picture p16: board BaSe_SATA_Adapter_HDD_V1_0.kicad_pcb from above]

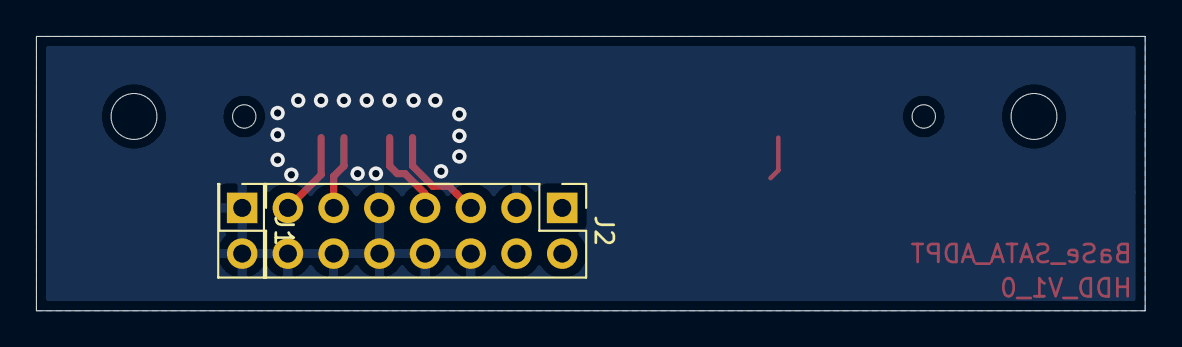
[picture p17: board BaSe_SATA_Adapter_HDD_V1_0.kicad_pcb from below]

Board: 2 copper layers, 61.6 x 15.2 mm, 5 parts (2 on the bottom side), 8 nets.

Parts:
J1: 821-22-002-10-002101; Conn_Spring_MaxMill_821-22-002-10-002101
J2: 823-22-014-10-001101; Conn_Spring_MaxMill_823-22-014-10-001101
PCB1: BaSe_SATA_Adapter_V1_0; BaSe_SATA_Adapter_HDD_V1_0
R1: No; R_0603_1608Metric_Pad1.05x0.95mm_HandSolder
X1: SATA_CONNECTOR_FEM; Conn_SATA_FEM_3M_5622-2222

Connections:
+5V: J2.1, X1.P7, X1.P8, X1.P9
+12V: J2.2, J2.4, X1.P13, X1.P14, X1.P15
/HDD_Rx+: J2.5, X1.S6
/HDD_Rx-: J2.7, X1.S5
/HDD_Tx+: J2.13, X1.S2
/HDD_Tx-: J2.11, X1.S3
/SPINUP_HDD: R1.2, X1.P11
GND: J1.1, J1.2, J2.3, J2.6, J2.8, J2.9, J2.10, J2.12, J2.14, R1.1, X1.P4, X1.P5, X1.P6, X1.P10, X1.P12, X1.S1, X1.S4, X1.S7
