M-Welsch/base-hardware/circuit_boards/base_dc_motor_test/base.kibot.yaml

# This is a working example.
# For a more complete reference use `--example`
kibot:
  version: 1

global:
  filters:
  - number: 1007
  - number: 1015
  - number: 58

filters:
- name: only_jlc_parts
  comment: Only parts with JLC (LCSC) code
  type: generic
  include_only:
  - column: LCSC#
    regex: ^C\d+

variants:
- name: place_holder
  comment: Just a place holder for pre_transform filters
  type: kicost
  pre_transform:
  - _kicost_rename
  - _rot_footprint

preflight:
  # [dict|list(dict)] Defines KiCad 6 variables.
  # They are expanded using ${VARIABLE}, and stored in the project file.
  # This preflight replaces `pcb_replace` and `sch_replace` when using KiCad 6.
  # The KiCad project file is modified.
  set_text_variables:
    - name: 'git_hash'
      command: 'git log -1 --format="%h" $KIBOT_PCB_NAME'
      before: 'Git hash: <'
      after: '>'

outputs:
- name: generic_bom_html
  comment: Generic Bill of Materials in HTML format
  type: bom
  dir: BoM/Generic
  options:
    format: HTML
    count_smd_tht: true
    columns:
    - References
    - Footprint
    - Quantity Per PCB
    - Value
    - MPN
    - Alternate
    - Description
- name: generic_bom_csv
  comment: Generic Bill of Materials in CSV format
  type: bom
  dir: BoM/Generic
  options:
    format: CSV
    count_smd_tht: true
    columns:
    - References
    - Footprint
    - Quantity Per PCB
    - Value
    - MPN
    - Alternate
    - Description
- name: generic_bom_xlsx
  comment: Generic Bill of Materials in XLSX format
  type: bom
  dir: BoM/Generic
  options:
    format: XLSX
    count_smd_tht: true
    columns:
    - References
    - Footprint
    - Quantity Per PCB
    - Value
    - MPN
    - Alternate
    - Description
- name: positional_bom_html
  comment: Positional Bill of Materials in HTML format
  type: bom
  dir: BoM/Positional
  options:
    format: HTML
    columns: &id001
    - Row
    - Description
    - Part
    - Part Lib
    - References
    - Value
    - Footprint
    - Footprint Lib
    - Quantity Per PCB
    - Build Quantity
    - Status
    - Datasheet
    - Sheetpath
    - Source BoM
    - Footprint X
    - Footprint Y
    - Footprint Rot
    - Footprint Side
    - Footprint Type
    - Footprint Populate
    - Footprint X-Size
    - Footprint Y-Size
    count_smd_tht: true
    html:
      style: modern-red
- name: positional_bom_xlsx
  comment: Positional Bill of Materials in XLSX format
  type: bom
  dir: BoM/Positional
  options:
    format: XLSX
    columns: *id001
    count_smd_tht: true
    xlsx:
      style: modern-red
- name: basic_excellon
  comment: Drill files in EXCELLON format
  type: excellon
  dir: Gerbers_and_Drill
  options:
    map: pdf
- name: basic_gencad
  comment: PCB in GenCAD format
  type: gencad
  dir: Export
- name: basic_gerb_drill
  comment: Drill files in GERB_DRILL format
  type: gerb_drill
  dir: Gerbers_and_Drill
  options:
    map: gerber
- name: gerber_modern
  comment: Gerbers in modern format, recommended by the standard
  type: gerber
  dir: Gerbers_and_Drill
  layers:
  - layer: F.Cu
    suffix: F_Cu
    description: Front copper
  - layer: B.Cu
    suffix: B_Cu
    description: Bottom copper
  - layer: F.Paste
    suffix: F_Paste
    description: Front solder paste
  - layer: B.Silkscreen
    suffix: B_Silkscreen
    description: Bottom silkscreen (artwork)
  - layer: F.Silkscreen
    suffix: F_Silkscreen
    description: Front silkscreen (artwork)
  - layer: B.Mask
    suffix: B_Mask
    description: Bottom soldermask (negative)
  - layer: F.Mask
    suffix: F_Mask
    description: Front soldermask (negative)
  - layer: User.Drawings
    suffix: User_Drawings
    description: User drawings
  - layer: User.Comments
    suffix: User_Comments
    description: User comments
  - layer: Edge.Cuts
    suffix: Edge_Cuts
    description: Board shape
  - layer: B.Courtyard
    suffix: B_Courtyard
    description: Bottom courtyard area
  - layer: F.Courtyard
    suffix: F_Courtyard
    description: Front courtyard area
  - layer: B.Fab
    suffix: B_Fab
    description: Bottom documentation
  - layer: F.Fab
    suffix: F_Fab
    description: Front documentation
- name: basic_info
  comment: Information about the run
  type: info
  dir: .
- name: classic_netlist
  comment: Schematic netlist in KiCad format
  type: netlist
  dir: Export
- name: ipc_netlist
  comment: IPC-D-356 netlist for testing
  type: netlist
  dir: Export
  options:
    format: ipc
- name: basic_pcb_print_pdf
  comment: PCB
  type: pcb_print
  dir: PCB
  options:
    format: PDF
    pages:
    - layers:
      - layer: F.Cu
      - layer: F.Mask
        color: '#14332440'
      - layer: F.Paste
      - layer: F.Silkscreen
      - layer: Edge.Cuts
      - layer: User.Drawings
      - layer: User.Comments
      sheet: Front copper
    - layers:
      - layer: B.Cu
      - layer: B.Mask
        color: '#14332440'
      - layer: B.Silkscreen
      - layer: Edge.Cuts
      - layer: User.Drawings
      - layer: User.Comments
      mirror: true
      sheet: Bottom copper
    - layers:
      - layer: B.Courtyard
      - layer: Edge.Cuts
      - layer: User.Drawings
      - layer: User.Comments
      mirror: true
      sheet: Bottom courtyard area
    - layers:
      - layer: F.Courtyard
      - layer: Edge.Cuts
      - layer: User.Drawings
      - layer: User.Comments
      sheet: Front courtyard area
    - layers:
      - layer: B.Fab
      - layer: Edge.Cuts
      - layer: User.Drawings
      - layer: User.Comments
      mirror: true
      sheet: Bottom documentation
    - layers:
      - layer: F.Fab
      - layer: Edge.Cuts
      - layer: User.Drawings
      - layer: User.Comments
      sheet: Front documentation
    keep_temporal_files: true
- name: basic_pdf
  comment: Individual layers in PDF format
  type: pdf
  dir: Individual_Layers
  layers:
  - layer: F.Cu
    suffix: F_Cu
    description: Front copper
  - layer: B.Cu
    suffix: B_Cu
    description: Bottom copper
  - layer: F.Paste
    suffix: F_Paste
    description: Front solder paste
  - layer: B.Silkscreen
    suffix: B_Silkscreen
    description: Bottom silkscreen (artwork)
  - layer: F.Silkscreen
    suffix: F_Silkscreen
    description: Front silkscreen (artwork)
  - layer: B.Mask
    suffix: B_Mask
    description: Bottom soldermask (negative)
  - layer: F.Mask
    suffix: F_Mask
    description: Front soldermask (negative)
  - layer: User.Drawings
    suffix: User_Drawings
    description: User drawings
  - layer: User.Comments
    suffix: User_Comments
    description: User comments
  - layer: Edge.Cuts
    suffix: Edge_Cuts
    description: Board shape
  - layer: B.Courtyard
    suffix: B_Courtyard
    description: Bottom courtyard area
  - layer: F.Courtyard
    suffix: F_Courtyard
    description: Front courtyard area
  - layer: B.Fab
    suffix: B_Fab
    description: Bottom documentation
  - layer: F.Fab
    suffix: F_Fab
    description: Front documentation
- name: basic_pdf_sch_print
  comment: Schematic in PDF format
  type: pdf_sch_print
  dir: Schematic
- name: basic_position_ASCII
  comment: Components position for Pick & Place
  type: position
  dir: Position
  options:
    format: ASCII
    only_smd: false
- name: basic_position_CSV
  comment: Components position for Pick & Place
  type: position
  dir: Position
  options:
    format: CSV
    only_smd: false
- name: basic_render_3d_top
  comment: 3D view from top
  type: render_3d
  dir: 3D
  options:
    ray_tracing: true
    orthographic: true
- name: basic_render_3d_30deg
  comment: 3D view from 30 degrees
  type: render_3d
  dir: 3D
  output_id: 30deg
  options:
    ray_tracing: true
    rotate_x: 3
    rotate_z: -2
- name: basic_render_3d_bottom
  comment: 3D view from bottom
  type: render_3d
  dir: 3D
  options:
    ray_tracing: true
    orthographic: true
    view: bottom
- name: report_simple
  comment: Simple design report
  type: report
  output_id: _simple
  options:
    template: simple_ASCII
- name: report_full
  comment: Full design report
  type: report
  options:
    template: full_SVG
- name: basic_step
  comment: 3D model in STEP format
  type: step
  dir: 3D
