M-Welsch/base-hardware/(commit log)

2023-03-07 second version, never built up. First version has no kicad files, just hand-sketches
    [Additional_Outputs.kicad_sch, BackupServer.kicad_sch, Motor_Driver.kicad_sch, Power_Distribution.kicad_sch]
2023-03-07 v2.0, made of the blue breadboard
    [Additional_Outputs.kicad_sch, BackupServer.kicad_sch, Motor_Driver.kicad_sch, Power_Distribution.kicad_sch]
2023-03-07 v3 with raspberry pi 4
    [BaSe_PWR_V3_1.kicad_pcb, BaSe_PWR_V3_1.kicad_sch, BackupServer.kicad_sch]
2023-03-08 new base pwr version
    [BaSe_PWR_V3_2.kicad_pcb, BaSe_PWR_V3_2.kicad_sch]
2023-03-08 first hmi board version
    [BaSe_HMI_V1_0.kicad_pcb, BaSe_HMI_V1_0.kicad_sch, BaSe_PWR_V3_1.kicad_pcb, BaSe_PWR_V3_1.kicad_sch]
2023-03-08 first version of sata adapter boards
    [BaSe_SATA_Adapter_Carriage_V1_0.kicad_pcb, BaSe_SATA_Adapter_Carriage_V1_0.kicad_sch, BaSe_SATA_Adapter_HDD_V1_0.kicad_pcb, BaSe_SATA_Adapter_HDD_V1_0.sch]
2023-03-08 production ready versions of sata adapter boards
    [BaSe_SATA_Adapter_Carriage_V1_0.kicad_pcb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]
2023-03-08 production ready version of base pwr
    [BaSe_PWR_V3_2-B_Mask.gbr, BaSe_PWR_V3_2-B_Paste.gbr, BaSe_PWR_V3_2-Edge_Cuts.gbr, BaSe_PWR_V3_2-F_Mask.gbr, BaSe_PWR_V3_2-F_Paste.gbr, BaSe_PWR_V3_2-L1_Sig_GND.gbr, BaSe_PWR_V3_2-L2_PWR_Split.gbr, BaSe_PWR_V3_2-L3_GND.gbr]
2023-03-08 production ready version of base hmi
    [BaSe_HMI_V1_0.kicad_pcb, BaSe_HMI_V1_0.kicad_sch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]
2023-03-08 add 3d printing parts (stl files)
    [BaSe_Auflager_Platinen_rev4.stl, BaSe_BP_HDD_rev1.stl, BaSe_Bodenplatte_rev3.stl, BaSe_HMI_Display_Abstandsrahmen_rev1.stl, BaSe_Schlitten_rev3_2020_07_19.stl, BaSe_rev1_Spannlager_Gegenstueck_2020_07_19.stl]
2023-03-08 add bill of materials
    [BaSe_rev3a_Stueckliste_V1_0.ods, BaSe_rev3b_Stueckliste_V1_0.ods]
2023-03-08 testboard for the motor driver and current measurement
    [BaSe_DC_Motor_Test_V1_0-B_Cu.gbr, BaSe_DC_Motor_Test_V1_0-B_Mask.gbr, BaSe_DC_Motor_Test_V1_0-B_Paste.gbr, BaSe_DC_Motor_Test_V1_0-Edge_Cuts.gbr, BaSe_DC_Motor_Test_V1_0-F_Cu.gbr, BaSe_DC_Motor_Test_V1_0-F_Mask.gbr, BaSe_DC_Motor_Test_V1_0-F_Paste.gbr, BaSe_DC_Motor_Test_V1_0-NPTH.drl]
2023-03-08 test pcb for the dockable usb connection
    [BaSe_SATA_Adapter_Carriage_V1_1-B_Cu.gbr, BaSe_SATA_Adapter_Carriage_V1_1-B_Mask.gbr, BaSe_SATA_Adapter_Carriage_V1_1-B_Paste.gbr, BaSe_SATA_Adapter_Carriage_V1_1-Edge_Cuts.gbr, BaSe_SATA_Adapter_Carriage_V1_1-F_Cu.gbr, BaSe_SATA_Adapter_Carriage_V1_1-F_Mask.gbr, BaSe_SATA_Adapter_Carriage_V1_1-F_Paste.gbr, BaSe_SATA_Adapter_Carriage_V1_1-NPTH.drl]
2023-03-12 shrinked hdd side part a little
    [BaSe_USB_Adapter_Carriage_V1_0.kicad_pcb]
2023-03-19 BaSe PWR V4.0: start new version
    [BaSe_PWR_V3_2-B_Mask.gbr, BaSe_PWR_V3_2-B_Paste.gbr, BaSe_PWR_V3_2-Edge_Cuts.gbr, BaSe_PWR_V3_2-F_Mask.gbr, BaSe_PWR_V3_2-F_Paste.gbr, BaSe_PWR_V3_2-L1_Sig_GND.gbr, BaSe_PWR_V3_2-L2_PWR_Split.gbr, BaSe_PWR_V3_2-L3_GND.gbr]
2023-03-27 base_pwr: rescure schematic parts from old version (v3.2) and start with mcu wiring
    [BaSe_PWR_V4_0.kicad_pcb, BaSe_PWR_V4_0.kicad_sch]
2023-03-30 BaSe_PWR_V4_0: wire up things
    [BaSe_PWR_V4_0.kicad_pcb, BaSe_PWR_V4_0.kicad_sch]
2023-04-02 BaSe PWR V4.0: more layout sketches
    [BaSe_PWR_V4_0.kicad_pcb, BaSe_PWR_V4_0.kicad_sch]
2023-04-03 BaSe PWR V4.0: design reverse polarity protection
    [BaSe_PWR_V4_0.kicad_pcb, BaSe_PWR_V4_0.kicad_sch]
2023-04-05 BaSe PWR V4.0: settle on rough component distribution
    [BaSe_PWR_V4_0.kicad_pcb, BaSe_PWR_V4_0.kicad_sch]
2023-04-07 BaSe PWR V4.0: split pcbs so all connectors can face far end.
    [BaSe_PWR_V4_0.kicad_pcb, BaSe_PWR_V4_0.kicad_sch]
2023-04-10 BaSe_PWR_V4_0: add last footprints, position components
    [BaSe_PWR_V4_0.kicad_pcb, BaSe_PWR_V4_0.kicad_sch]
2023-04-11 BaSe PWR V4.0: add stub for power backup based on 9V block
    [BaSe_PWR_V4_0.kicad_pcb, BaSe_PWR_V4_0.kicad_sch]
2023-04-13 BaSe PWR V4.0: add endwitch
    [BaSe_PWR_V4_0.kicad_pcb, BaSe_PWR_V4_0.kicad_sch]
2023-04-14 BaSe PWR V4.0: add 3d models, define layer stackup
    [BaSe_PWR_V4_0.kicad_pcb, BaSe_PWR_V4_0.kicad_sch]
2023-04-23 BaSe PWR V4.0: push to MCAD. Moved some stuff.
    [BaSe_PWR_V4_0.kicad_pcb, BaSe_PWR_V4_0.kicad_sch]
2023-04-25 BaSe PWR V4.0: quasi final positioning before actual routing phase
    [BaSe_PWR_V4_0.kicad_pcb]
2023-04-27 BaSe PWR V4.0: probably final placement, start routing
    [BaSe_PWR_V4_0.kicad_pcb, BaSe_PWR_V4_0.kicad_sch]
2023-05-03 BaSe_PWR_V4_0: add gnd planes on outer layers, thicked up DC input tracks to carry 5A
    [BaSe_PWR_V4_0.kicad_pcb, BaSe_PWR_V4_0.kicad_sch]
2023-05-08 almost finished layout
    [BaSe_PWR_V4_0.kicad_pcb]
2023-05-08 BaSe_PWR_V4_0: put DCDC coil to bottom, reduce loop area
    [BaSe_PWR_V4_0.kicad_pcb]
2023-05-09 BaSe PWR V4.0: rotate b2b connectors 180 degree for shorter pwr tracks
    [BaSe_PWR_V4_0.kicad_pcb, BaSe_PWR_V4_0.kicad_sch]
2023-05-14 Base PWR V4.0: optimize pinout for b2b connectors
    [BaSe_PWR_V4_0.kicad_pcb, BaSe_PWR_V4_0.kicad_sch]
2023-05-15 BaSe PWR V4.0: resolve DRC errors
    [BaSe_PWR_V4_0.kicad_pcb, BaSe_PWR_V4_0.kicad_sch]
2023-05-15 BaSe PWR V4.0: production ready
    [BaSe_PWR_V4_0.kicad_pcb]
2023-05-15 BaSe_PWR_V4_0: add stitching vias
    [BaSe_PWR_V4_0.kicad_pcb]
2023-05-22 BaSe PWR V4.0: increase distance between USB lines and GND on same layers
    [BaSe_PWR_V4_0.kicad_pcb]
2023-07-29 update resistor values for supply sense
    [BaSe_PWR_V4_0.kicad_pcb, BaSe_PWR_V4_0.kicad_sch]
2024-01-03 bom changes after bringup
    [BaSe_PWR_V4_0.kicad_pcb, BaSe_PWR_V4_0.kicad_sch]
